grakh/MyGreenhouse/GSM_Poliv/schematic.pdf

LM2596

## Module

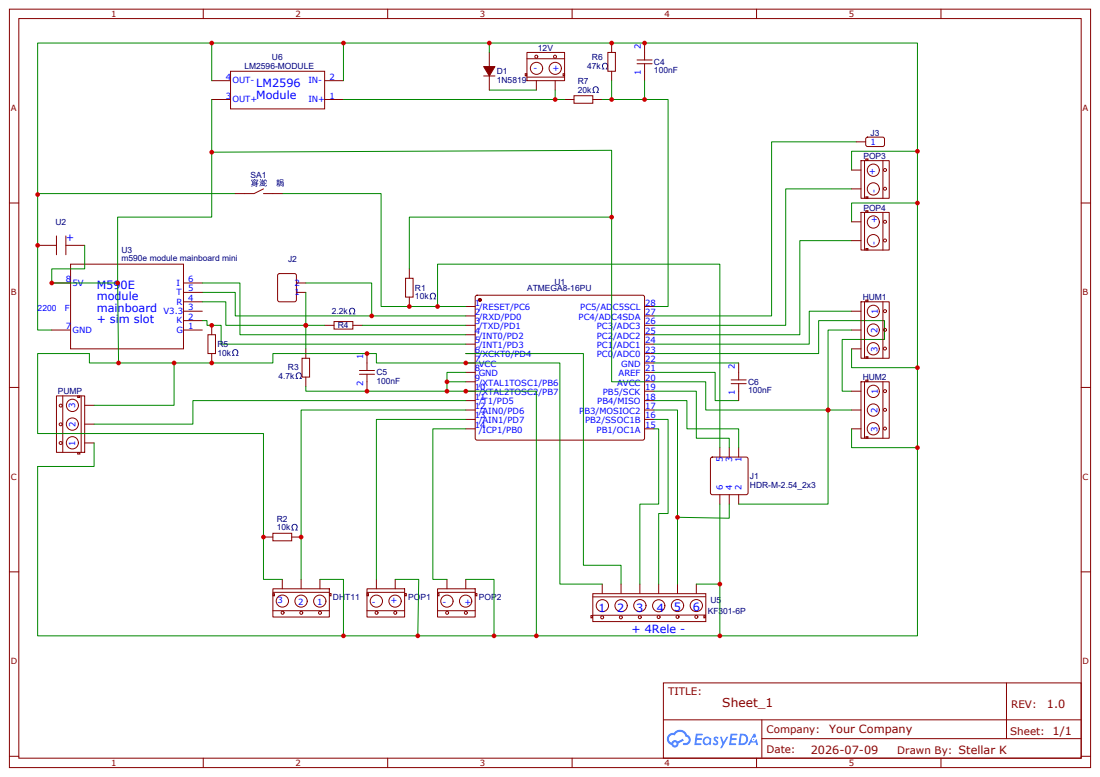
[picture p1: page 1]
