grakh/MyGreenhouse/Tnew.pdf

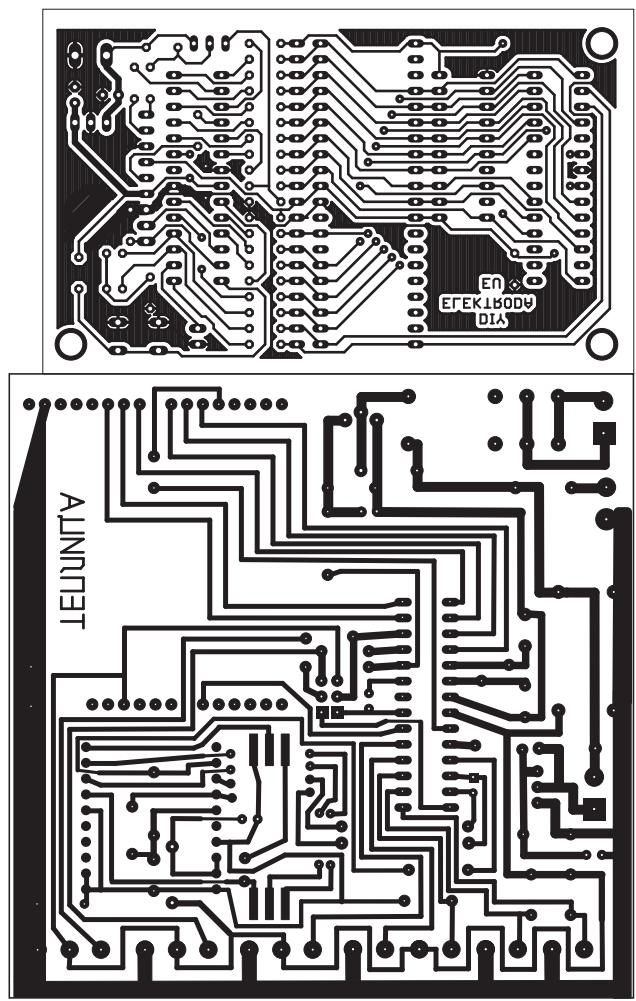
[picture p2: page 1]
