grakh/MyGreenhouse/(list of files, drawings)

Other design files:
GSM_Poliv/greenhouse.lay6
Tepl_new.lay6
