grakh/MyGreenhouse/(commit log)

2017-12-23 Teplica 328 first commit
    [Tepl_new.lay6]
2026-10-28 GSM_Poliv: прошивка полива с SMS-управлением (ATmega328P + M590E)
2026-10-28 GSM_Poliv: печатная плата (Sprint Layout)
    Claude-Session: https://claude.ai/code/session_01Kgggg83qvuiTuoLhS1BCkH
2026-10-28 GSM_Poliv: README — файл платы
    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
